scottdube/geo-aux-heat-monitor/Mech/geo-aux-heat-pcb.step

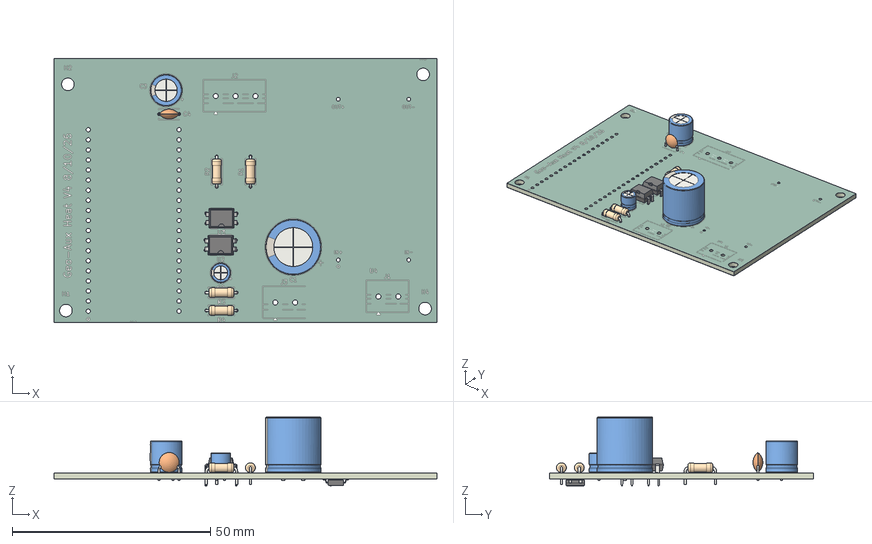
[picture p1: CAD file, 2026-09-18]
Mech/geo-aux-heat-pcb.step
96.5 x 66.5 x 17.3 mm
R_Axial_DIN0207_L63mm_D25mm_P762mm_Horizontal x 4
CP_Radial_D50mm_P200mm
CP_Radial_D80mm_P350mm
DIP-4_W7.62mm x 2
CP_Radial_D140mm_P500mm
C_Disc_D50mm_W25mm_P500mm
TO-269AA
sln-geo-aux-heat_silkscreen x 2
sln-geo-aux-heat_soldermask x 2
sln-geo-aux-heat_PCB
