scottdube/geo-aux-heat-monitor/(commit log)

2026-08-20 Geo aux heat monitor: ESPHome config, ADR, and BOM
    ESP32 monitor for the geothermal auxiliary heat stage. Credentials are
    referenced via ESPHome's !secret indirection and secrets.yaml is gitignored,
    so nothing here carries a key.
    BOM.md is generated from InvenTree (part #834, BO-0007) and records where each
    part physically lives.
2026-08-20 Record the as-built BOM and correct the build status
    The board was designed, milled on the Tormach, and populated; the README
    still said "not yet built or flashed" from the day the ADR was accepted.
    The as-built BOM comes from sln-geo-aux-heat.kicad_sch, which diverges from
    the ADR in three places worth knowing: the opto dropping resistors are
    3.3k/100k rather than the 10-15k guessed, the per-opto front-end bridges were
    never populated, and the filter cap is 470uF/63V rather than the 50V minimum.
    docs/bom.md is kept for decision history with a header saying not to order
    from it.
    InvenTree BOM for part 834 goes from 3 lines to 12. Two parts were missing
    from the catalog and were created: MB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
2026-08-20 Regenerate BOM.md — MB10S now resolves to the split bridge kit
2026-09-18 re-sync ADR + ESPHome copies from canonical; log the drift as a trap
    Both copies had gone stale against sln-ha-config despite the README saying
    they are kept byte-identical: the ADR copy was 215 lines against canonical's
    450, missing the whole 2026-08-10 build/bench-validation amendment, and the
    YAML still carried the pre-erratum pin map (GPIO25/26/27 instead of the
    as-built GPIO32/33 + GPIO34).
    That cost something real -- a live hardware question was answered from the
    copy and the wrong pins were stated. TRAPS.md records it.
    Not fixed by a symlink or a CI diff here, though either would be the durable
    answer: this repo is also the pcbmill regression fixture and I did not want
    to change how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
    [geo-aux-heat-pcb.step]
